brahmanandan/BLE-Sniffer/enclosure/images/2-102010694-seeedstudio-xiao-nrf52840-sense-plus-45font_1.jpg

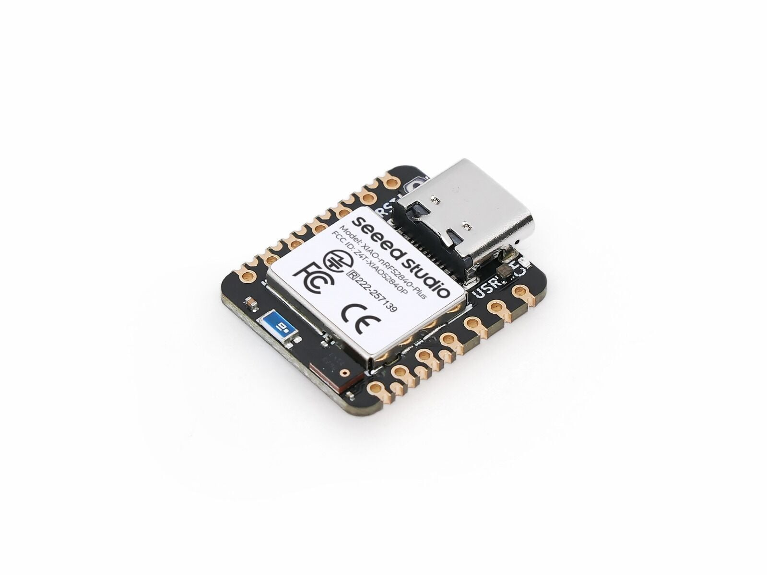
enclosure/images/2-102010694-seeedstudio-xiao-nrf52840-sense-plus-45font_1.jpg
