brahmanandan/BLE-Sniffer/enclosure/images/5-102010694-seeedstudio-xiao-nrf52840-sense-plus-45back_1.jpg

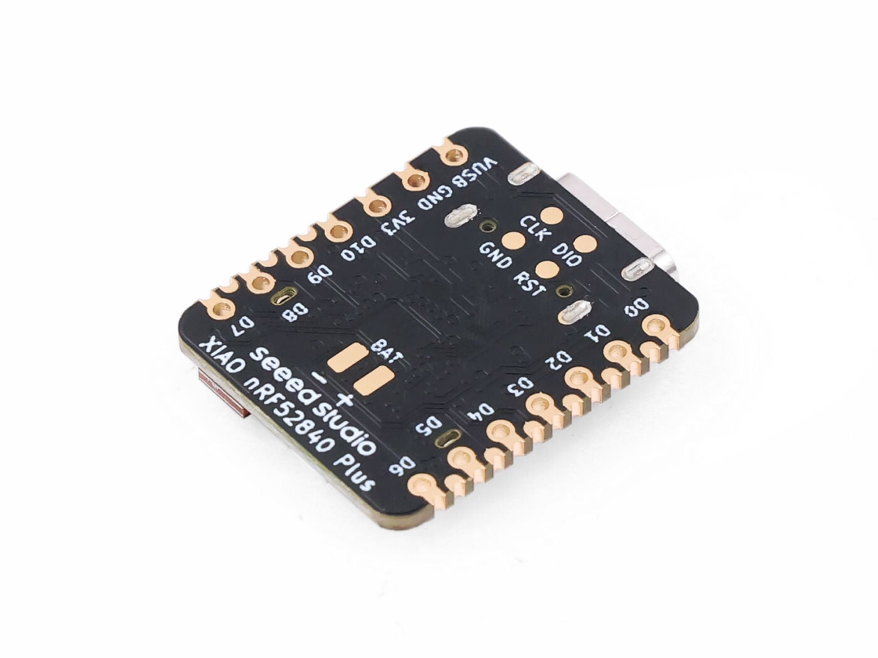
enclosure/images/5-102010694-seeedstudio-xiao-nrf52840-sense-plus-45back_1.jpg
