brahmanandan/BLE-Sniffer/enclosure/bt_case_param_base.stl

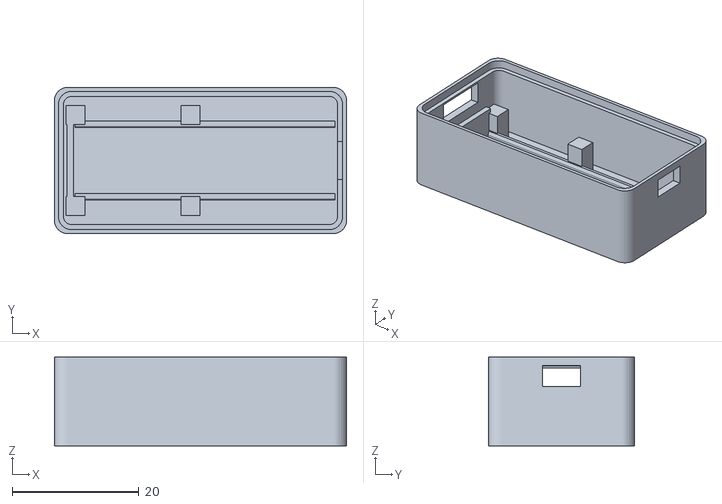
[picture p27: CAD file, 2026-10-31]
enclosure/bt_case_param_base.stl
46.0 x 23.0 x 14.0
