brahmanandan/BLE-Sniffer/enclosure/bt_case_lid.stl

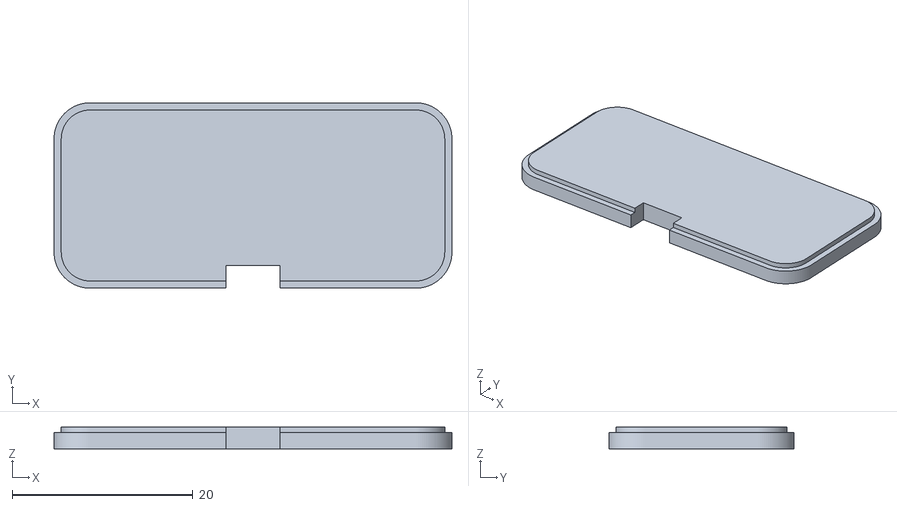
[picture p28: CAD file, 2026-10-31]
enclosure/bt_case_lid.stl
44.0 x 20.5 x 2.40
