brahmanandan/BLE-Sniffer/enclosure/bt_case_base.stl

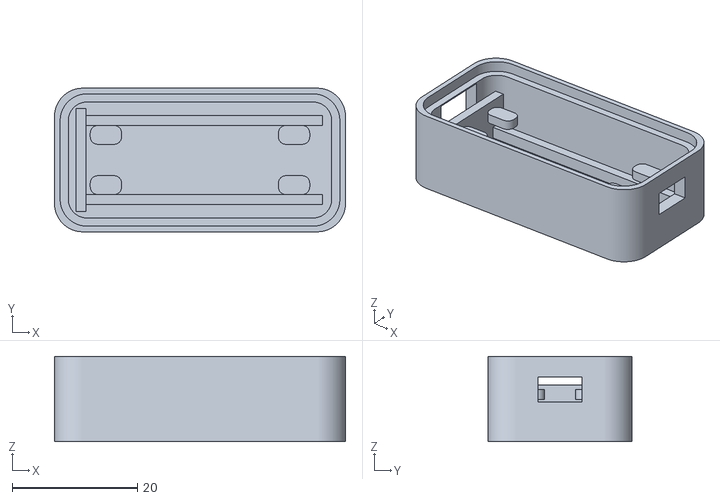
[picture p29: CAD file, 2026-10-31]
enclosure/bt_case_base.stl
46.4 x 22.9 x 13.6
