brahmanandan/BLE-Sniffer/enclosure/bt_case_param_pads.stl

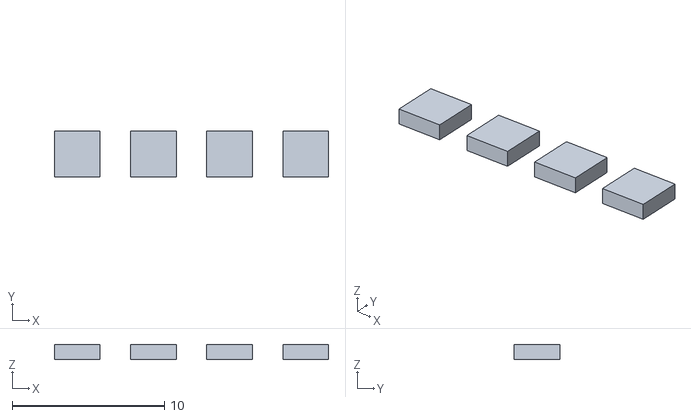
[picture p30: CAD file, 2026-10-31]
enclosure/bt_case_param_pads.stl
18.0 x 3.00 x 1.00
