brahmanandan/BLE-Sniffer/enclosure/bt_case_param_lid.stl

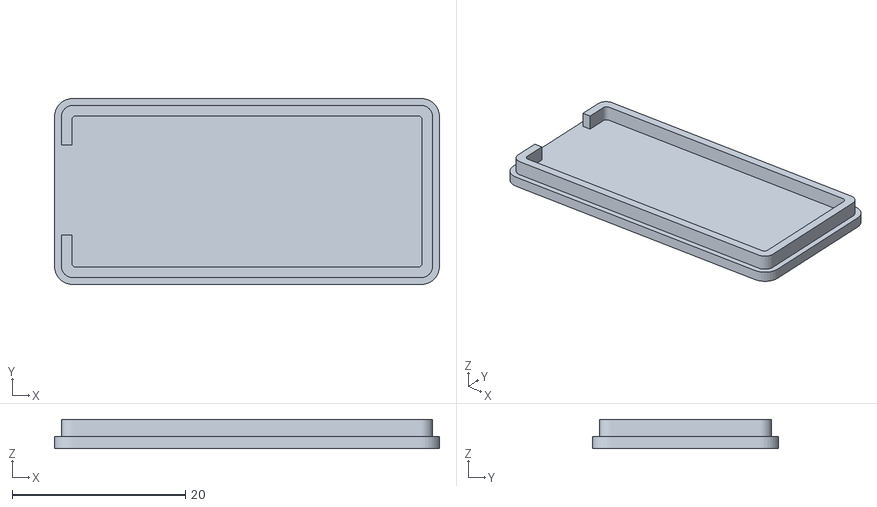
[picture p31: CAD file, 2026-10-31]
enclosure/bt_case_param_lid.stl
44.5 x 21.5 x 3.40
